Legged-robot/bldc_hardware/README.md

# BLDC motor controller Hardware

| Eagle PCB| Mounted PCB Controller |
:-:|:-:
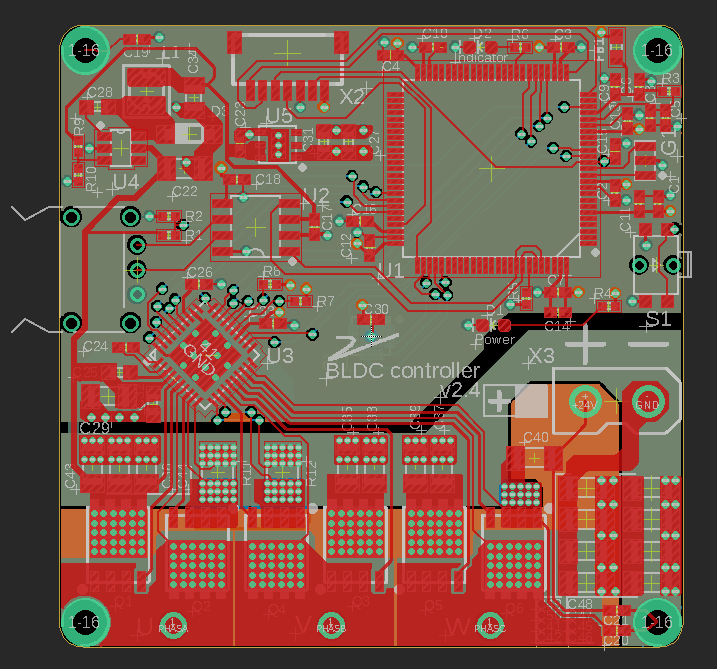
[picture p1: docs/custom_BLDC_PCB.png]
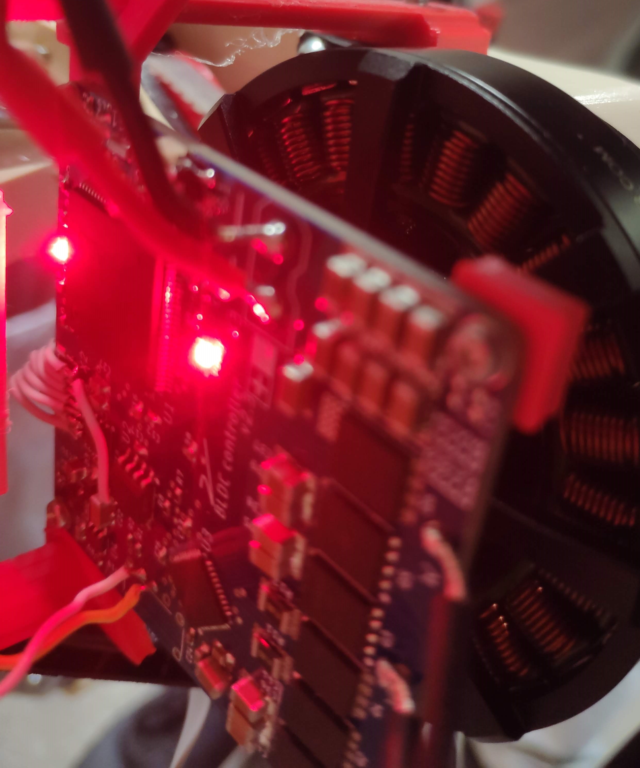
[picture p2: docs/PCB_mounted.jpg]
 |  

## Credits
Controller based on [3phase_integrated from Ben Katz](https://github.com/bgkatz/3phase_integrated)
