Legged-robot/bldc_hardware/docs/BenKatzPCB.png

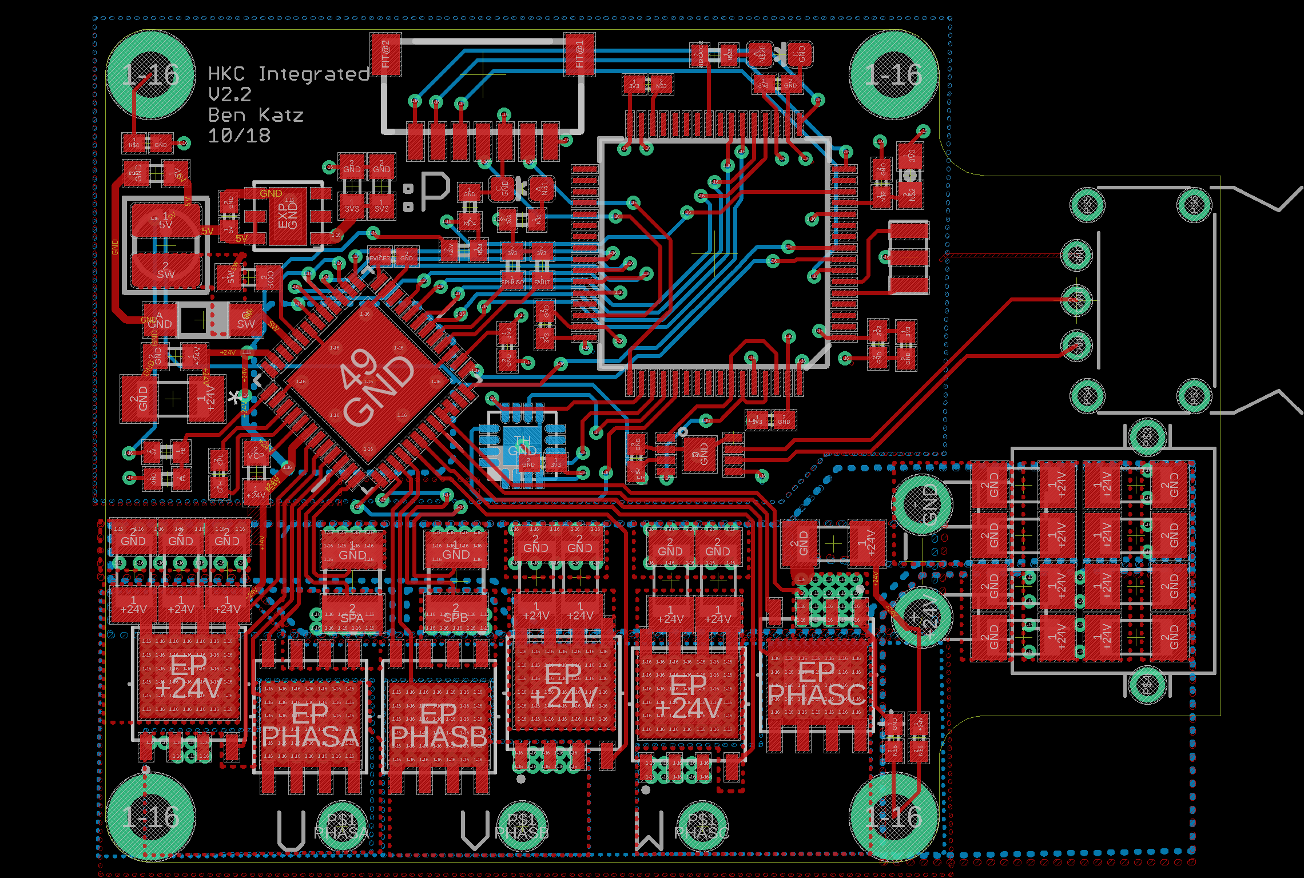
docs/BenKatzPCB.png
