Legged-robot/bldc_hardware/docs/BenKatzSchematics.png

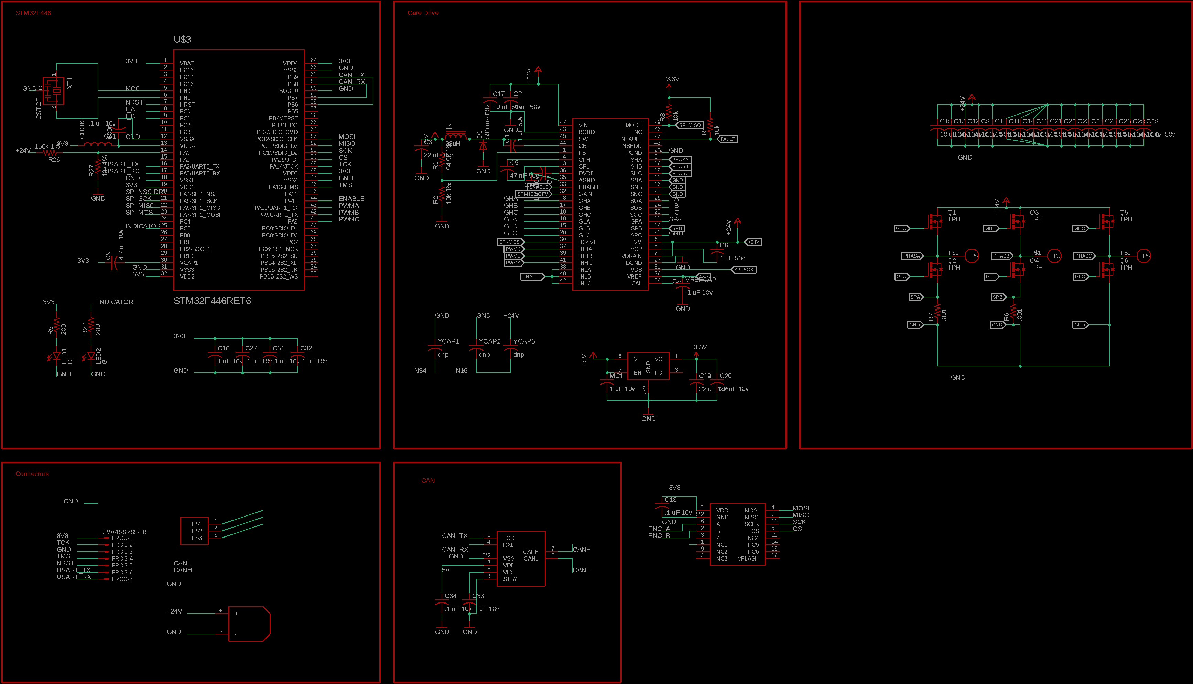
docs/BenKatzSchematics.png
