Legged-robot/bldc_hardware/HKCV5_BOM.xlsx

Part | Value | Device | Package | Description | Quantity | Manufacturer Number
C1 C5 C9 C26 | 1 uF 10v | C-USC0402K | C0402K | CAPACITOR, American symbol | 4 | CL05A105KP5NNNC (https://www.mouser.de/ProductDetail/Samsung-Electro-Mechanics/CL05A105KP5NNNC)
C2 C3 C4 C6 C7 C8 C11 C12 C13 C15 C18 C30 C33 | .1 uF 10v | C-USC0402K | C0402K | CAPACITOR, American symbol | 13 | CL05B104KP5NNNC‎
C10 C16 | 2.2 uF 10v | C-USC0402K | C0402K | CAPACITOR, American symbol | 2 | CL05A225KP7NSB8 (https://www.mouser.de/ProductDetail/Samsung-Electro-Mechanics/CL05A225KP7NSB8)
C14 | 4.7 uF 10v | C-USC0402K | C0402K | CAPACITOR, American symbol | 1 | ‎GRM155R60J475ME87D‎
C17 | .1 uF 25v | C-USC0402K | C0402K | CAPACITOR, American symbol | 1 | GRM155R61E104KA87D (https://www.mouser.de/ProductDetail/Murata-Electronics/GRM155R61E104KA87D)
C19 C20 C21 | dnp | C-USC0402K | C0402K | CAPACITOR, American symbol | 3 | --------
C22 C29 C35 C36 C37 C38 C39 C40 C41 C42 C43 C44 C45 C46 C47 C48 C49 C50 | 10 uF 50v | C-USC1206K | C1206K | CAPACITOR, American symbol | 18 | GRT31CR61H106ME01L
C23 | 1 uF 25v | C-USC0402K | C0402K | CAPACITOR, American symbol | 1 | GRT155R61E105ME01D (https://www.mouser.de/ProductDetail/Murata-Electronics/GRT155R61E105ME01D)
C24 | 47 nF 50v | C-USC0402K | C0402K | CAPACITOR, American symbol | 1 | ‎CGA2B3X7R1H473M050BD‎
C25 | 1 uF 50v | C-USC0603K | C0603K | CAPACITOR, American symbol | 1 | UMK107BJ105KA-T
C27 C31 | 22 uF 10v | C-USC0603K | C0603K | CAPACITOR, American symbol | 2 | ‎CL10A226MPCNUBE‎
C28 C32 | .1 uF 50v | C-USC0603K | C0603K | CAPACITOR, American symbol | 2 | ‎CC0603JRX7R9BB104‎
C34 | 22 uF 25V | C-USC0805K | C0805K | CAPACITOR, American symbol | 1 | GRM21BR61E226ME44K (https://www.mouser.de/ProductDetail/Murata-Electronics/GRM21BR61E226ME44K?qs=hNud%2FORuBR25jDsUehWlrQ%3D%3D)
R1 | 150k 1% | R-US_R0402 | R0402 | RESISTOR, American symbol | 1 | ‎RMCF0402FT150K‎
R2 R5 R7 R8 R10 | 10k 1% | R-US_R0402 | R0402 | RESISTOR, American symbol | 5 | RT0402DRE0710KL (https://www.mouser.de/ProductDetail/Yageo/RT0402DRE0710KL)
R3 | 47 1% | R-US_R0402 | R0402 | RESISTOR, American symbol | 1 | RC0402FR-0747RL (https://www.mouser.de/ProductDetail/Yageo/RC0402FR-0747RL)
R4 R6 | 200 | R-US_R0402 | R0402 | RESISTOR, American symbol | 2 | ‎RC0402JR-07200RL‎
R9 | 54.9k 1% | R-US_R0402 | R0402 | RESISTOR, American symbol | 1 | ‎RC0402FR-0754K9L‎
R11 R12 | 1m | R-US_R1210 | R1210 | RESISTOR, American symbol | 2 | ‎PMR25HZPFV1L00‎
S1 | TL1014BF160QG | TL1014BF160QG | TL1014 | TL1014BF160QG | 1 | TL1014BF160QG (https://www.mouser.de/ProductDetail/E-Switch/TL1014BF160QG?qs=fi7yB2oewZns8aaNfLjQ9Q%3D%3D)
X1 | M80-8430342 | M80-3-PIN | M80-8430342 | M80-8430342 | 1 | M80-8430342
X2 | SM07B-SRSS-TB | SM07B-SRSS-TB | SM07B-SRSS-TB | SM07B-SRSS-TB | 1 | SM07B-SRSS-TB(LF)(SN)
X3 | FIT0586 | FIT0586 | XT30 |  | 1 | FIT0586
X4 X5 X6 | 18_AWG | 18_AWG_PADSINGLE | 18_AWG_PAD | 18_AWG | 3 | --------
L1 | 22uH | SDR0302 | SDR0302 | POWER INDUCTOR | 1 | ‎NRH3012T220MN‎
FB1 | 600Ω@100MHz/0.5A | FERRITE_BEAD-0603 | 603 | Ferrite Bead (blocks, cores, rings, chokes, etc.) | 1 | ‎PE-0603FB601ST‎
Q1 Q2 Q3 Q4 Q5 Q6 | CSD18540Q5BT | CSD18540Q5BT | 8-POWERTDFN | CSD18540Q5B | 6 | TPH1R306PL,L1Q CSD18540Q5B
D1 D2 | G | LED0603 | LED-0603 | LED (Generic) | 2 | LTST-C191KRKT‎
D3 | 500 mA 60v | DIODE-SOD123 | SOD123 | DIODE | 1 | ‎MBR0580S1-7‎
G1 | CSTNE8M00GH5L000R0 | CSTNE8M00GH5L000R0 | CSTCE | CSTNE8M00GH5L000R0 | 1 | ‎CSTNE8M00GH5L000R0‎
U1 | STM32F446VET6TR | STM32F446VET6TR | LQFP100 | STM32F446VET6TR | 1 | STM32F446VET6TR
U2 | MCP2542FD-H/SN | MCP2542FD-H/SN | 8-LEADSOIC | MCP2542FD-H/SN | 1 | MCP2542FD-H/SN
U3 | DRV8323SRTAT | DRV8323SRTAT | RTA-PACKAGE | DRV8323SRTAT | 1 | DRV8323SRTAT
U4 | LMR16006XDDCR | LMR16006XDDCR | SOT-23-6-THIN | LMR16006XDDCR | 1 | LMR16006XDDCR
U5 | LDFM33PUR | LDFM33PUR | DFN6-3X3 |  | 1 | LDFM33PUR
U6 | MA700GQ-Z | MA700GQ-Z | QFN16 | MA700GQ-Z | 1 | MA700GQ-Z
Additional components:
Male connector for M80-8430342 | 855-M80-8980305 |  |  |  | 1 | 855-M80-8980305 (https://www.mouser.de/ProductDetail/Harwin/M80-8980305)
Male connector for SM07B-SRSS-TB(LF)(SN) | A07SR07SR30K152B |  |  |  |  | A07SR07SR30K152B
