Legged-robot/bldc_hardware/HKCV5.pdf

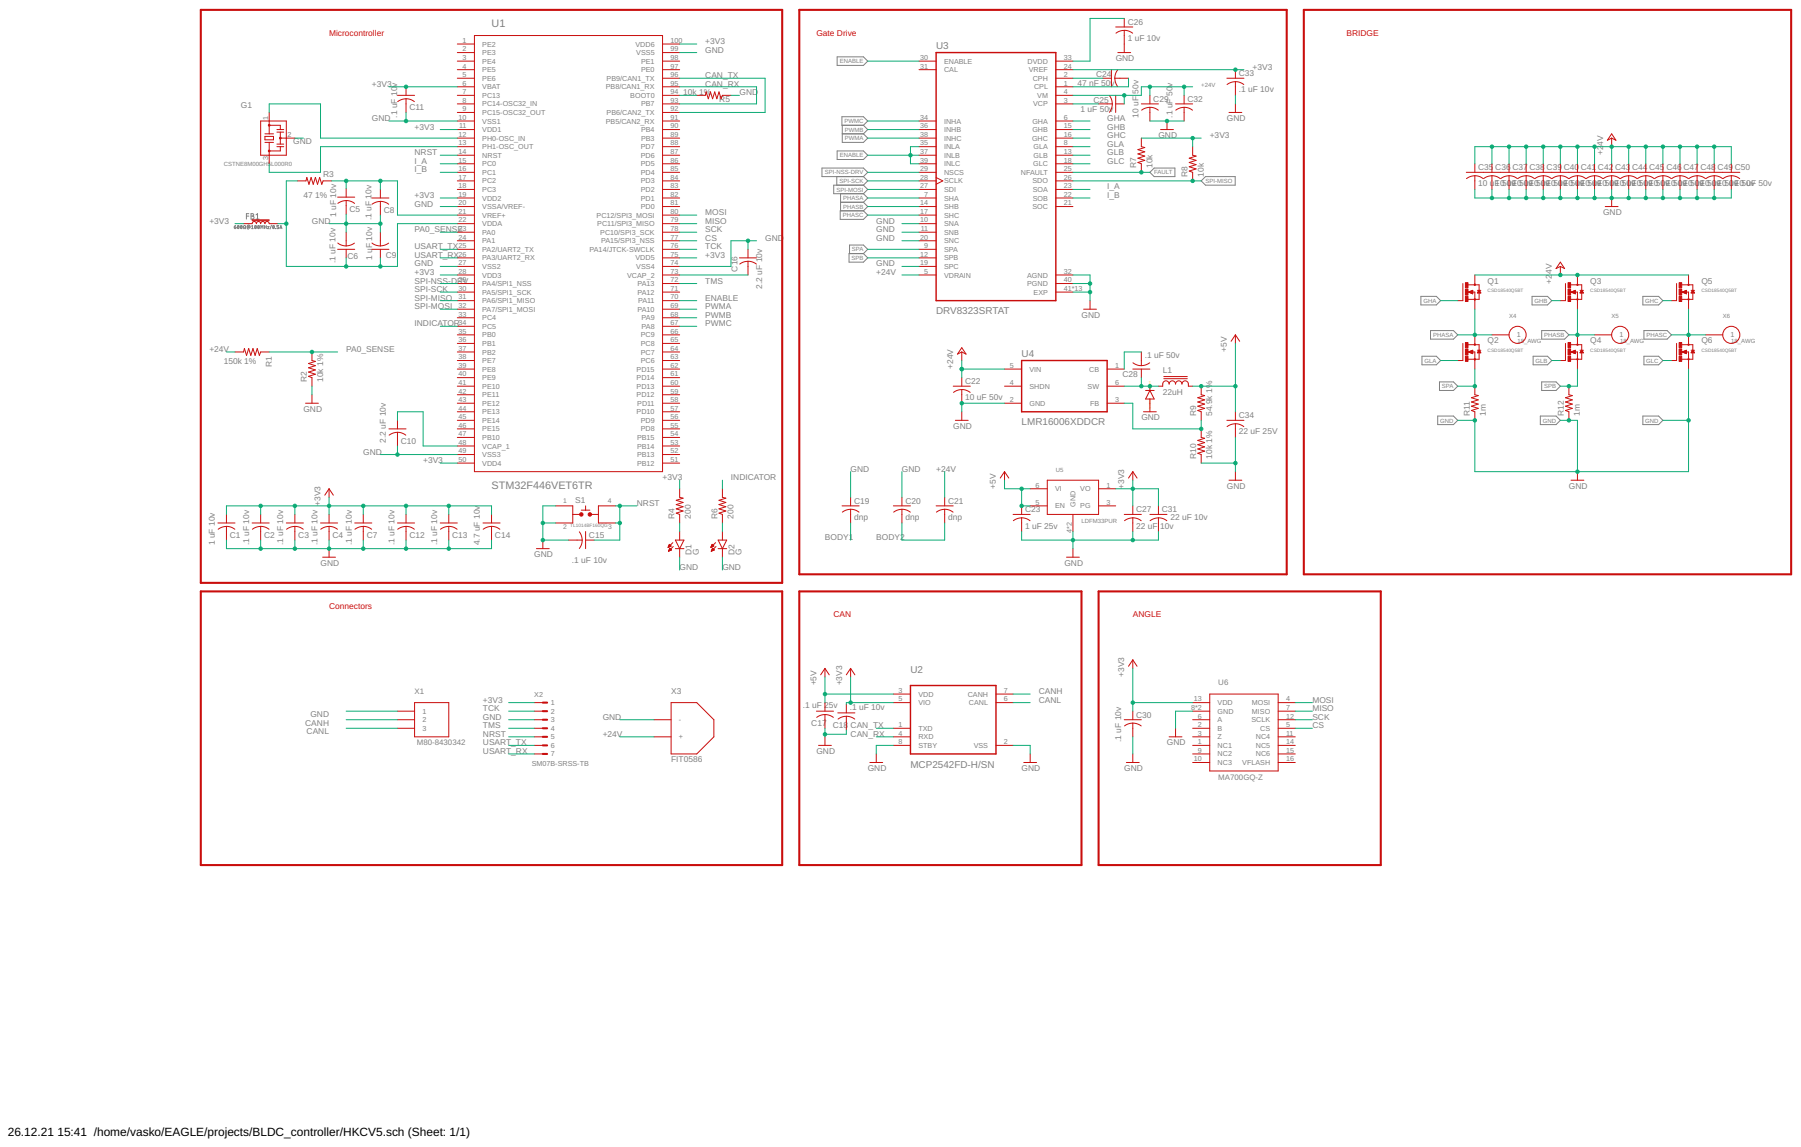
[picture p5: page 1]

26.12.21 15:41 /home/vasko/EAGLE/projects/BLDC_controller/HKCV5.sch (Sheet: 1/1)
