Legged-robot/bldc_hardware/HKCV5.brd

## EAGLE design HKCV5.brd (2021-12-26)

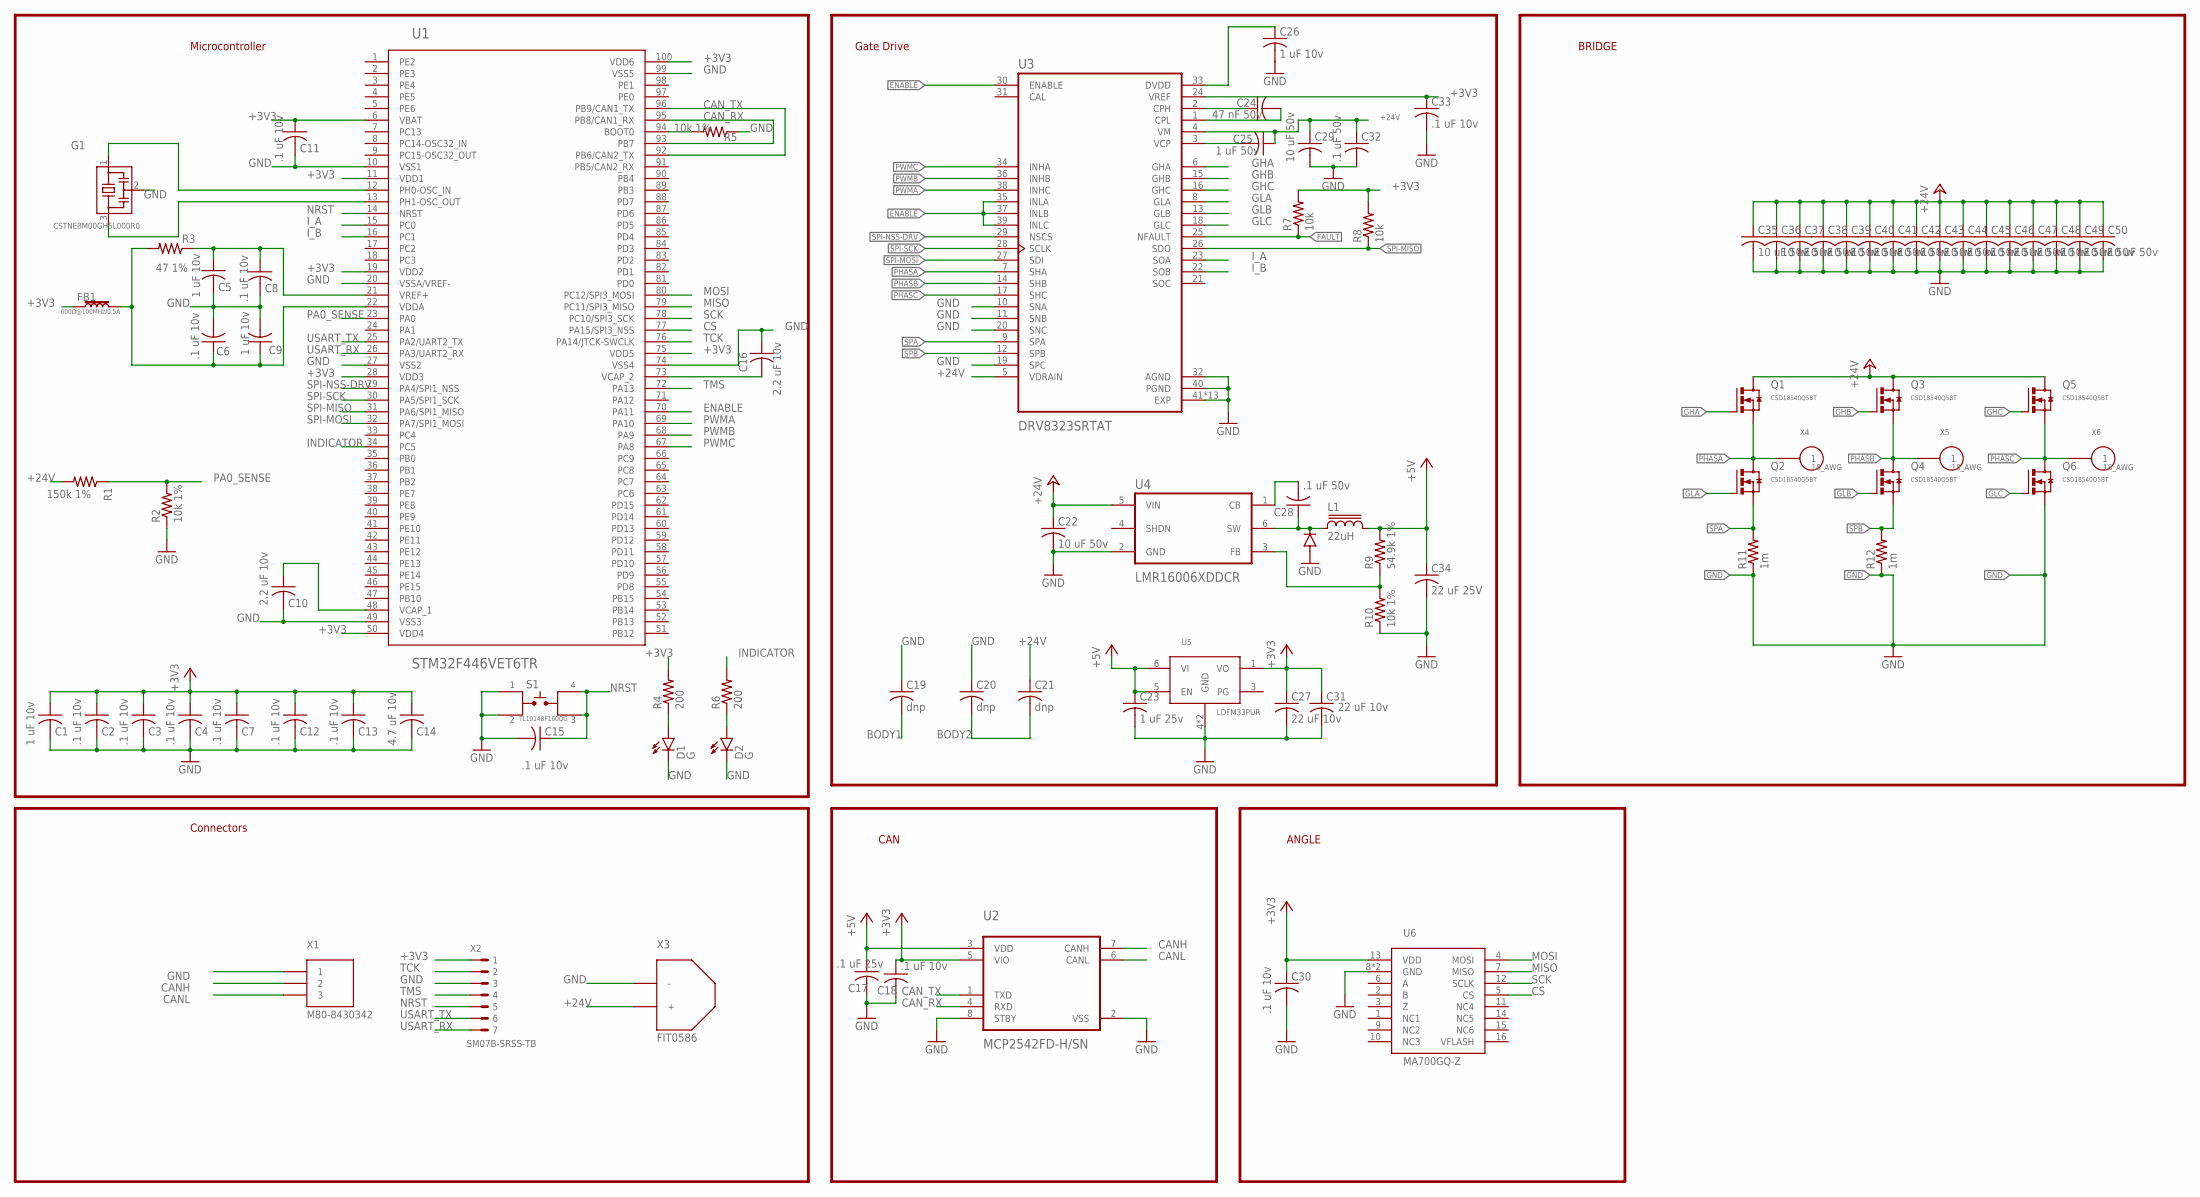
[picture p6: schematic HKCV5.sch]

Parts:
C1, C5, C9, C26: 1 uF 10v; C0402K
C2, C3, C4, C6, C7, C8, C11, C12, C13, C15, C18, C30, C33: .1 uF 10v; C0402K
C10, C16: 2.2 uF 10v; C0402K
C14: 4.7 uF 10v; C0402K
C17: .1 uF 25v; C0402K
C19, C20, C21: dnp; C0402K
C22, C29, C35, C36, C37, C38, C39, C40, C41, C42, C43, C44, C45, C46, C47, C48, C49, C50: 10 uF 50v; C1206K
C23: 1 uF 25v; C0402K
C24: 47 nF 50v; C0402K
C25: 1 uF 50v; C0603K
C27, C31: 22 uF 10v; C0603K
C28, C32: .1 uF 50v; C0603K
C34: 22 uF 25V; C0805K
D1, D2: G; LED-0603
D3: 500 mA 60v; SOD123
FB1: 600Ω@100MHz/0.5A; 0603
G1: CSTNE8M00GH5L000R0; CSTCE
L1: 22uH; SDR0302
Q1, Q2, Q3, Q4, Q5, Q6: CSD18540Q5BT; 8-POWERTDFN
R1: 150k 1%; R0402
R2, R5, R10: 10k 1%; R0402
R3: 47 1%; R0402
R4, R6: 200; R0402
R7, R8: 10k; R0402
R9: 54.9k 1%; R0402
R11, R12: 1m; R1210
S1: TL1014BF160QG; TL1014
U1: STM32F446VET6TR; LQFP100
U2: MCP2542FD-H/SN; 8-LEADSOIC
U3: DRV8323SRTAT; RTA-PACKAGE
U4: LMR16006XDDCR; SOT-23-6-THIN
U5: LDFM33PUR; DFN6-3X3
U6: MA700GQ-Z; QFN16
X1: M80-8430342
X2: SM07B-SRSS-TB
X3: FIT0586; XT30
X4, X5, X6: 18_AWG; 18_AWG_PAD

Connections:
+3V3: C1.1, C2.1, C3.1, C4.1, C7.1, C11.1, C12.1, C13.1, C14.1, C18.1, C27.1, C30.1, C31.1, C33.1, FB1.1, R4.2, R7.2, R8.2, U1.6 (VBAT), U1.11 (VDD1), U1.19 (VDD2), U1.28 (VDD3), U1.50 (VDD4), U1.75 (VDD5), U1.100 (VDD6), U2.5 (VIO), U3.24 (VREF), U5.1 (VO), U6.13 (VDD), X2.1
+5V: C17.1, C23.1, C34.1, L1.2, R9.2, U2.3 (VDD), U5.5 (EN), U5.6 (VI)
+24V: C21.1, C22.1, C25.1, C29.1, C32.1, C35.1, C36.1, C37.1, C38.1, C39.1, C40.1, C41.1, C42.1, C43.1, C44.1, C45.1, C46.1, C47.1, C48.1, C49.1, C50.1, Q1.5_1 (D), Q1.5_2 (D), Q1.5_3 (D), Q1.5_4 (D), Q1.5_5 (D), Q1.5_6 (D), Q1.5_7 (D), Q1.5_8 (D), Q1.5_9 (D), Q1.5_10 (D), Q1.5_11 (D), Q1.5_12 (D), Q1.5_13 (D), Q1.5_14 (D), Q1.5_15 (D), Q1.5_16 (D), Q1.5_17 (D), Q1.5_18 (D), Q1.5_19 (D), Q1.5_20 (D), Q1.5_21 (D), Q1.5_22 (D), Q1.5_23 (D), Q1.5_24 (D), Q1.5_25 (D), Q1.5_26 (D), Q1.5_27 (D), Q1.5_28 (D), Q1.5_29 (D), Q1.5_30 (D), Q3.5_1 (D), Q3.5_2 (D), Q3.5_3 (D), Q3.5_4 (D), Q3.5_5 (D), Q3.5_6 (D), Q3.5_7 (D), Q3.5_8 (D), Q3.5_9 (D), Q3.5_10 (D), Q3.5_11 (D), Q3.5_12 (D), Q3.5_13 (D), Q3.5_14 (D), Q3.5_15 (D), Q3.5_16 (D), Q3.5_17 (D), Q3.5_18 (D), Q3.5_19 (D), Q3.5_20 (D), Q3.5_21 (D), Q3.5_22 (D), Q3.5_23 (D), Q3.5_24 (D), Q3.5_25 (D), Q3.5_26 (D), Q3.5_27 (D), Q3.5_28 (D), Q3.5_29 (D), Q3.5_30 (D), Q5.5_1 (D), Q5.5_2 (D), Q5.5_3 (D), Q5.5_4 (D), Q5.5_5 (D), Q5.5_6 (D), Q5.5_7 (D), Q5.5_8 (D), Q5.5_9 (D), Q5.5_10 (D), Q5.5_11 (D), Q5.5_12 (D), Q5.5_13 (D), Q5.5_14 (D), Q5.5_15 (D), Q5.5_16 (D), Q5.5_17 (D), Q5.5_18 (D), Q5.5_19 (D), Q5.5_20 (D), Q5.5_21 (D), Q5.5_22 (D), Q5.5_23 (D), Q5.5_24 (D), Q5.5_25 (D), Q5.5_26 (D), Q5.5_27 (D), Q5.5_28 (D), Q5.5_29 (D), Q5.5_30 (D), R1.2, U3.4 (VM), U3.5 (VDRAIN), U4.5 (VIN), X3.+
BODY1: C19.2
BODY2: C20.2, C21.2
BOOT0: R5.2, U1.94 (BOOT0)
CANH: U2.7 (CANH), X1.2
CANL: U2.6 (CANL), X1.3
CAN_RX: U1.93 (PB7), U1.95 (PB8/CAN1_RX), U2.4 (RXD)
CAN_TX: U1.92 (PB6/CAN2_TX), U1.96 (PB9/CAN1_TX), U2.1 (TXD)
CB: C28.2, U4.1 (CB)
CPH: C24.1, U3.2 (CPH)
CPL: C24.2, U3.1 (CPL)
CS: U1.77 (PA15/SPI3_NSS), U6.5 (CS)
D1: D1.A, R4.1
D2: D2.A, R6.1
DVDD: C26.1, U3.33 (DVDD)
ENABLE: U1.70 (PA11), U3.30 (ENABLE), U3.35 (INLA), U3.37 (INLB), U3.39 (INLC)
FAULT: R7.1, U3.25 (NFAULT)
FB: R9.1, R10.2, U4.3 (FB)
GHA: Q1.4 (G), U3.6 (GHA)
GHB: Q3.4 (G), U3.15 (GHB)
GHC: Q5.4 (G), U3.16 (GHC)
GLA: Q2.4 (G), U3.8 (GLA)
GLB: Q4.4 (G), U3.13 (GLB)
GLC: Q6.4 (G), U3.18 (GLC)
GND: C1.2, C2.2, C3.2, C4.2, C5.2, C6.2, C7.2, C8.2, C9.2, C10.2, C11.2, C12.2, C13.2, C14.2, C15.2, C16.1, C17.2, C18.2, C19.1, C20.1, C22.2, C23.2, C26.2, C27.2, C29.2, C30.2, C31.2, C32.2, C33.2, C34.2, C35.2, C36.2, C37.2, C38.2, C39.2, C40.2, C41.2, C42.2, C43.2, C44.2, C45.2, C46.2, C47.2, C48.2, C49.2, C50.2, D1.C, D2.C, D3.A, G1.2, Q6.1 (S), Q6.2 (S), Q6.3 (S), R2.1, R5.1, R10.1, R11.1, R12.1, S1.1, S1.2, U1.10 (VSS1), U1.20 (VSSA/VREF-), U1.27 (VSS2), U1.49 (VSS3), U1.74 (VSS4), U1.99 (VSS5), U2.2 (VSS), U2.8 (STBY), U3.10 (SNA), U3.11 (SNB), U3.19 (SPC), U3.20 (SNC), U3.32 (AGND), U3.40 (PGND), U3.41 (EXP), U3.41_1 (EXP), U3.41_2 (EXP), U3.41_3 (EXP), U3.41_4 (EXP), U3.41_5 (EXP), U3.41_6 (EXP), U3.41_7 (EXP), U3.41_8 (EXP), U3.41_9 (EXP), U3.41_10 (EXP), U3.41_11 (EXP), U3.41_12 (EXP), U4.2 (GND), U5.4 (GND), U5.EXP (GND), U6.8 (GND), U6.TH (GND), X1.1, X2.3, X3.-
INDICATOR: R6.2, U1.34 (PC5)
I_A: U1.15 (PC0), U3.23 (SOA)
I_B: U1.16 (PC1), U3.22 (SOB)
MISO: U1.79 (PC11/SPI3_MISO), U6.7 (MISO)
MOSI: U1.80 (PC12/SPI3_MOSI), U6.4 (MOSI)
NRST: C15.1, S1.3, S1.4, U1.14 (NRST), X2.5
OSC_IN: G1.1, U1.12 (PH0-OSC_IN)
OSC_OUT: G1.3, U1.13 (PH1-OSC_OUT)
PA0_SENSE: R1.1, R2.2, U1.23 (PA0)
PHASA: Q1.1 (S), Q1.2 (S), Q1.3 (S), Q2.5_1 (D), Q2.5_2 (D), Q2.5_3 (D), Q2.5_4 (D), Q2.5_5 (D), Q2.5_6 (D), Q2.5_7 (D), Q2.5_8 (D), Q2.5_9 (D), Q2.5_10 (D), Q2.5_11 (D), Q2.5_12 (D), Q2.5_13 (D), Q2.5_14 (D), Q2.5_15 (D), Q2.5_16 (D), Q2.5_17 (D), Q2.5_18 (D), Q2.5_19 (D), Q2.5_20 (D), Q2.5_21 (D), Q2.5_22 (D), Q2.5_23 (D), Q2.5_24 (D), Q2.5_25 (D), Q2.5_26 (D), Q2.5_27 (D), Q2.5_28 (D), Q2.5_29 (D), Q2.5_30 (D), U3.7 (SHA), X4.1
PHASB: Q3.1 (S), Q3.2 (S), Q3.3 (S), Q4.5_1 (D), Q4.5_2 (D), Q4.5_3 (D), Q4.5_4 (D), Q4.5_5 (D), Q4.5_6 (D), Q4.5_7 (D), Q4.5_8 (D), Q4.5_9 (D), Q4.5_10 (D), Q4.5_11 (D), Q4.5_12 (D), Q4.5_13 (D), Q4.5_14 (D), Q4.5_15 (D), Q4.5_16 (D), Q4.5_17 (D), Q4.5_18 (D), Q4.5_19 (D), Q4.5_20 (D), Q4.5_21 (D), Q4.5_22 (D), Q4.5_23 (D), Q4.5_24 (D), Q4.5_25 (D), Q4.5_26 (D), Q4.5_27 (D), Q4.5_28 (D), Q4.5_29 (D), Q4.5_30 (D), U3.14 (SHB), X5.1
PHASC: Q5.1 (S), Q5.2 (S), Q5.3 (S), Q6.5_1 (D), Q6.5_2 (D), Q6.5_3 (D), Q6.5_4 (D), Q6.5_5 (D), Q6.5_6 (D), Q6.5_7 (D), Q6.5_8 (D), Q6.5_9 (D), Q6.5_10 (D), Q6.5_11 (D), Q6.5_12 (D), Q6.5_13 (D), Q6.5_14 (D), Q6.5_15 (D), Q6.5_16 (D), Q6.5_17 (D), Q6.5_18 (D), Q6.5_19 (D), Q6.5_20 (D), Q6.5_21 (D), Q6.5_22 (D), Q6.5_23 (D), Q6.5_24 (D), Q6.5_25 (D), Q6.5_26 (D), Q6.5_27 (D), Q6.5_28 (D), Q6.5_29 (D), Q6.5_30 (D), U3.17 (SHC), X6.1
PWMA: U1.69 (PA10), U3.38 (INHC)
PWMB: U1.68 (PA9), U3.36 (INHB)
PWMC: U1.67 (PA8), U3.34 (INHA)
SCK: U1.78 (PC10/SPI3_SCK), U6.12 (SCLK)
SPA: Q2.1 (S), Q2.2 (S), Q2.3 (S), R11.2, U3.9 (SPA)
SPB: Q4.1 (S), Q4.2 (S), Q4.3 (S), R12.2, U3.12 (SPB)
SPI-MISO: R8.1, U1.31 (PA6/SPI1_MISO), U3.26 (SDO)
SPI-MOSI: U1.32 (PA7/SPI1_MOSI), U3.27 (SDI)
SPI-NSS-DRV: U1.29 (PA4/SPI1_NSS), U3.29 (NSCS)
SPI-SCK: U1.30 (PA5/SPI1_SCK), U3.28 (SCLK)
SW: C28.1, D3.C, L1.1, U4.6 (SW)
TCK: U1.76 (PA14/JTCK-SWCLK), X2.2
TMS: U1.72 (PA13), X2.4
USART_RX: U1.26 (PA3/UART2_RX), X2.7
USART_TX: U1.25 (PA2/UART2_TX), X2.6
VCAP_1: C10.1, U1.48 (VCAP_1)
VCAP_2: C16.2, U1.73 (VCAP_2)
VCP: C25.2, U3.3 (VCP)
VDDA: C6.1, C9.1, FB1.2, R3.2, U1.22 (VDDA)
VREF+: C5.1, C8.1, R3.1, U1.21 (VREF+)

Notes on the sheet:
Gate Drive
Microcontroller
CAN
Connectors
ANGLE
BRIDGE

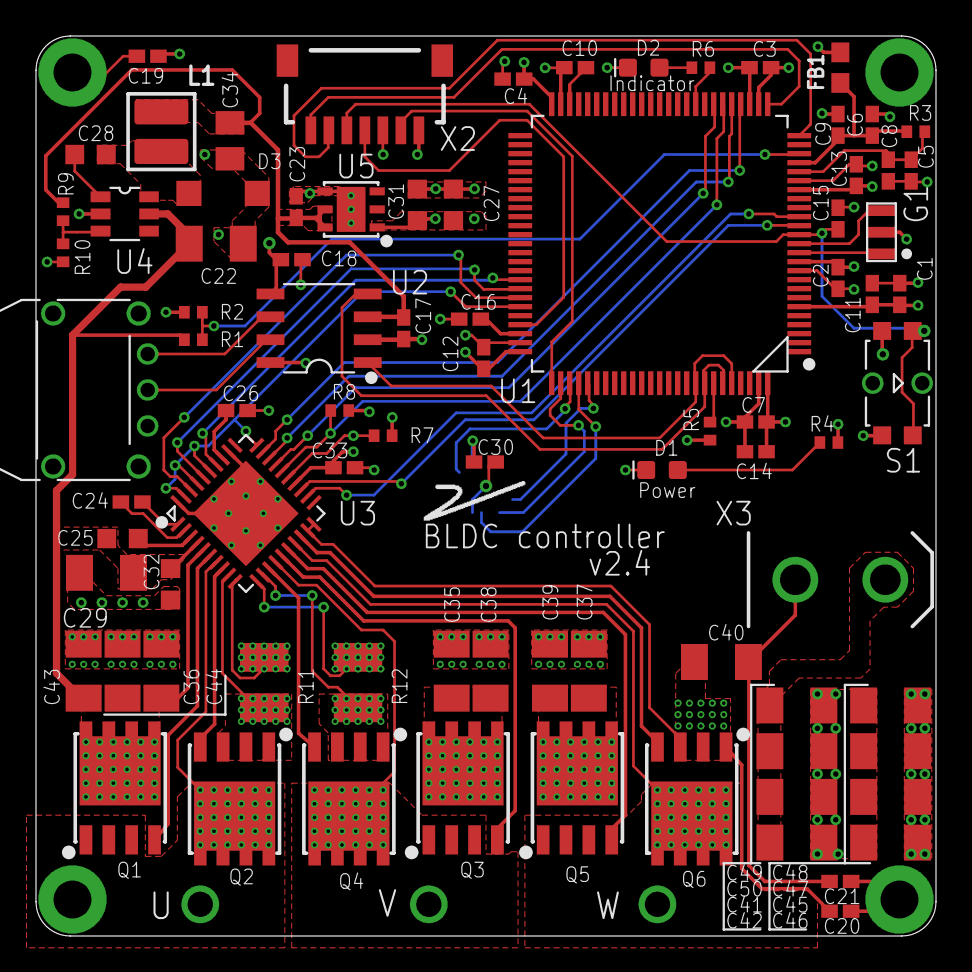
[picture p7: board HKCV5.brd from above]

Board: 4 copper layers, 50.0 x 50.0 mm, 87 parts (1 on the bottom side), 58 nets.
