Legged-robot/bldc_hardware/(commit log)

2021-04-01 HKC Integrated V2.2 from Ben Katz
    [HKCV4.brd, HKCV4.sch]
2021-04-05 Ignore history files. Board Pictures
2021-04-20 v2.3 Ready for review
    [HKCV5.brd, HKCV5.sch]
2021-04-22 CAP rated voltage increase, BOM
    [HKCV5.brd, HKCV5.sch, HKCV5_BOM.xlsx]
2021-04-29 Pre-final - board sent to JLCPCB on review
    [HKCV5.brd]
2021-12-26 Mistakes discovered after using PCB
    [HKCV4.brd, HKCV4.sch, HKCV5.brd, HKCV5.sch]
